studentma-maker/slj_stm32f407_pro/Document/三联机嵌入式主控板原理图_2026-08-20.pdf

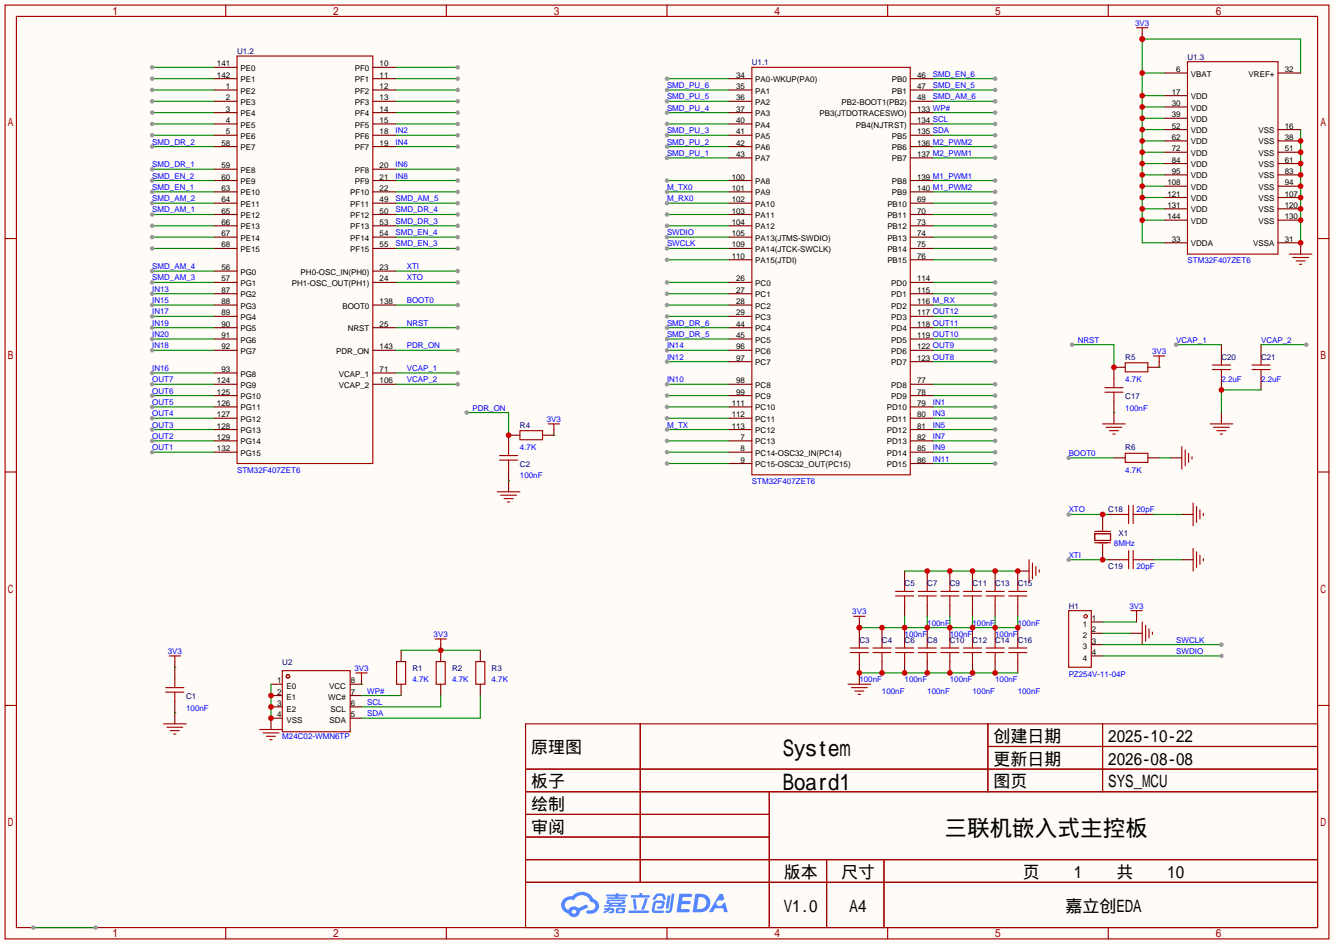
[picture p1: page 1]

原理图 | System | 创建日期 | 2025-10-22

更新日期 | 2026-08-08

板子 | Board1 | 图页 | SYS_MCU
绘制 | | 三联机嵌入式主控板
审阅

V1.0 | A4 | 嘉立创EDA

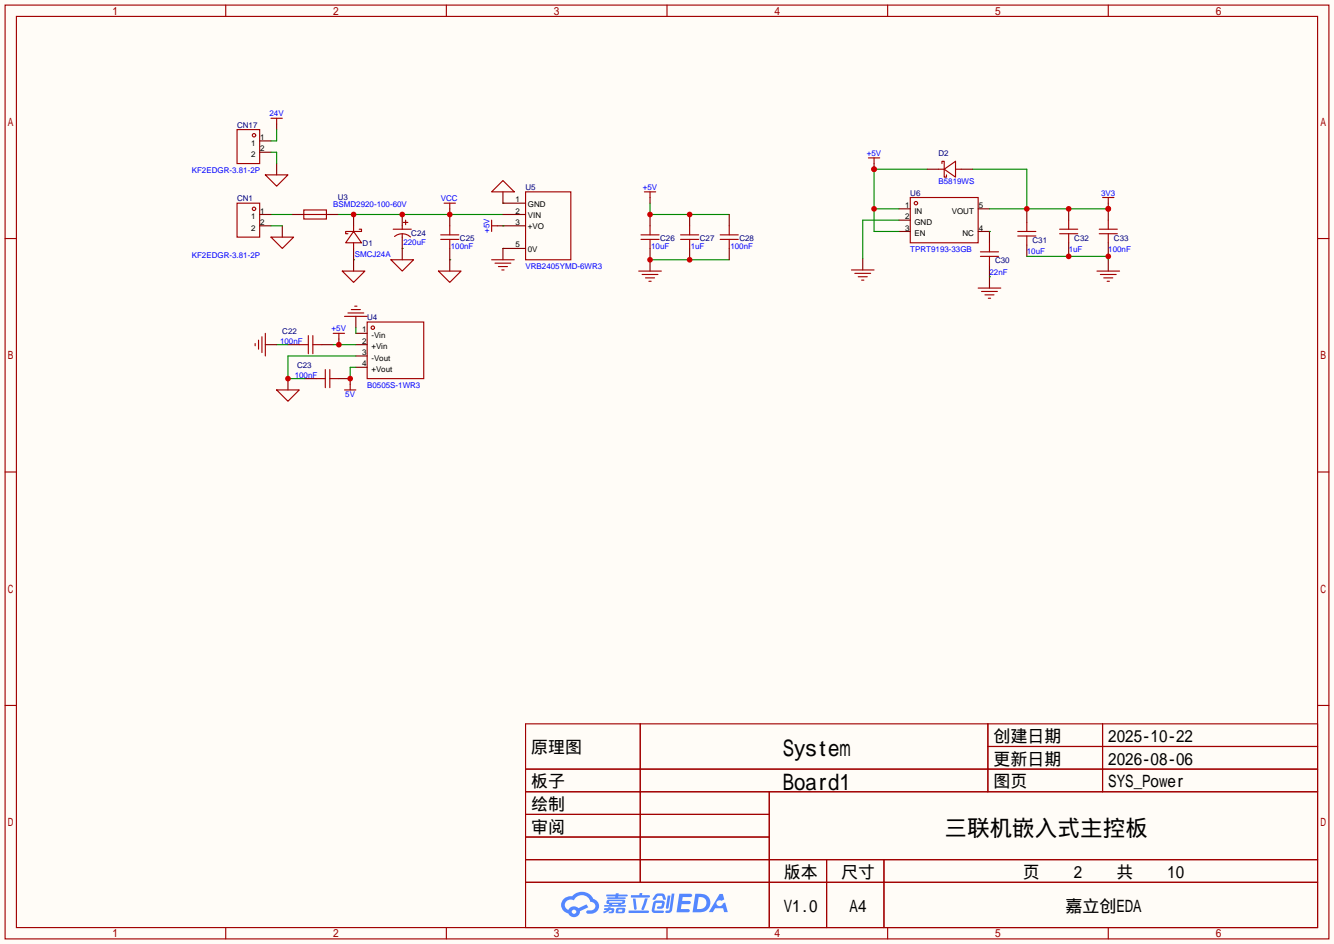
[picture p2: page 2]

原理图 | System | 创建日期 | 2025-10-22

更新日期 | 2026-08-06

板子 | Board1 | 图页 | SYS_Power
绘制 | | 三联机嵌入式主控板
审阅

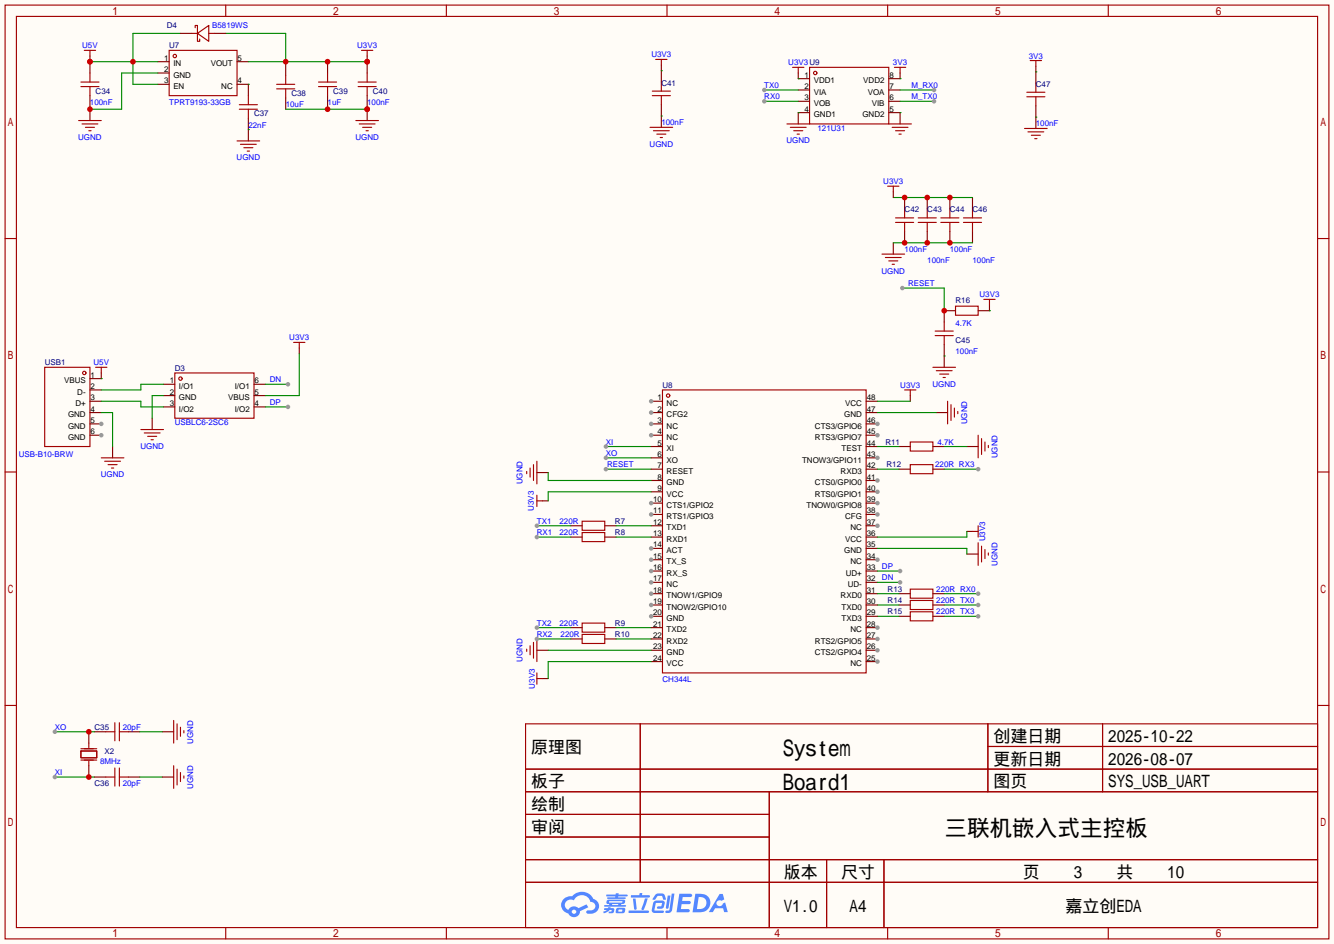
[picture p3: page 3]

原理图 | System | 创建日期 | 2025-10-22

更新日期 | 2026-08-07

板子 | Board1 | 图页 | SYS_USB_UART
绘制 | | 三联机嵌入式主控板
审阅

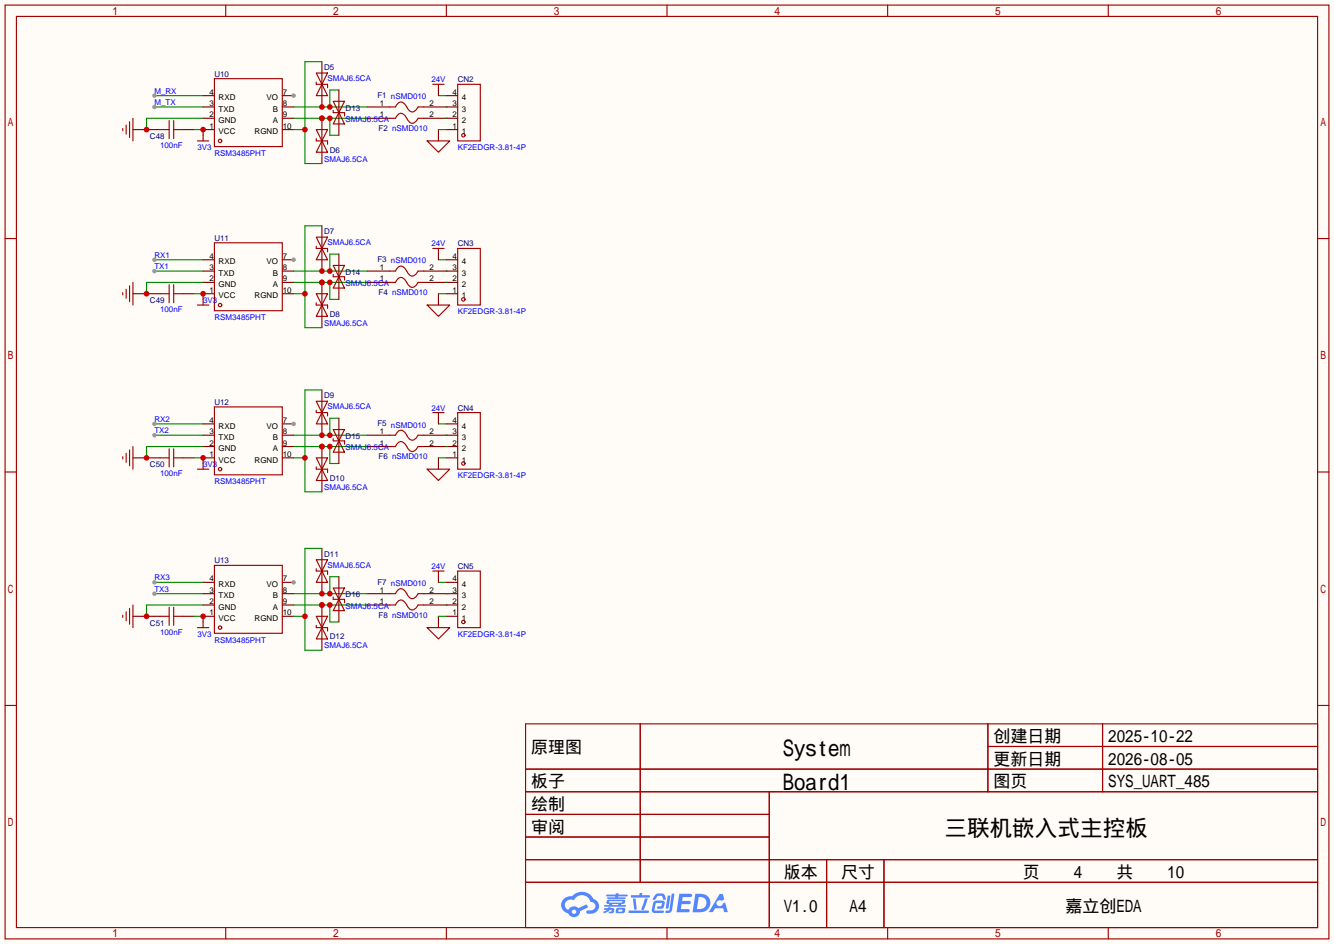
[picture p4: page 4]

原理图 | System | 创建日期 | 2025-10-22

更新日期 | 2026-08-05

板子 | Board1 | 图页 | SYS_UART_485
绘制 | | 三联机嵌入式主控板
审阅

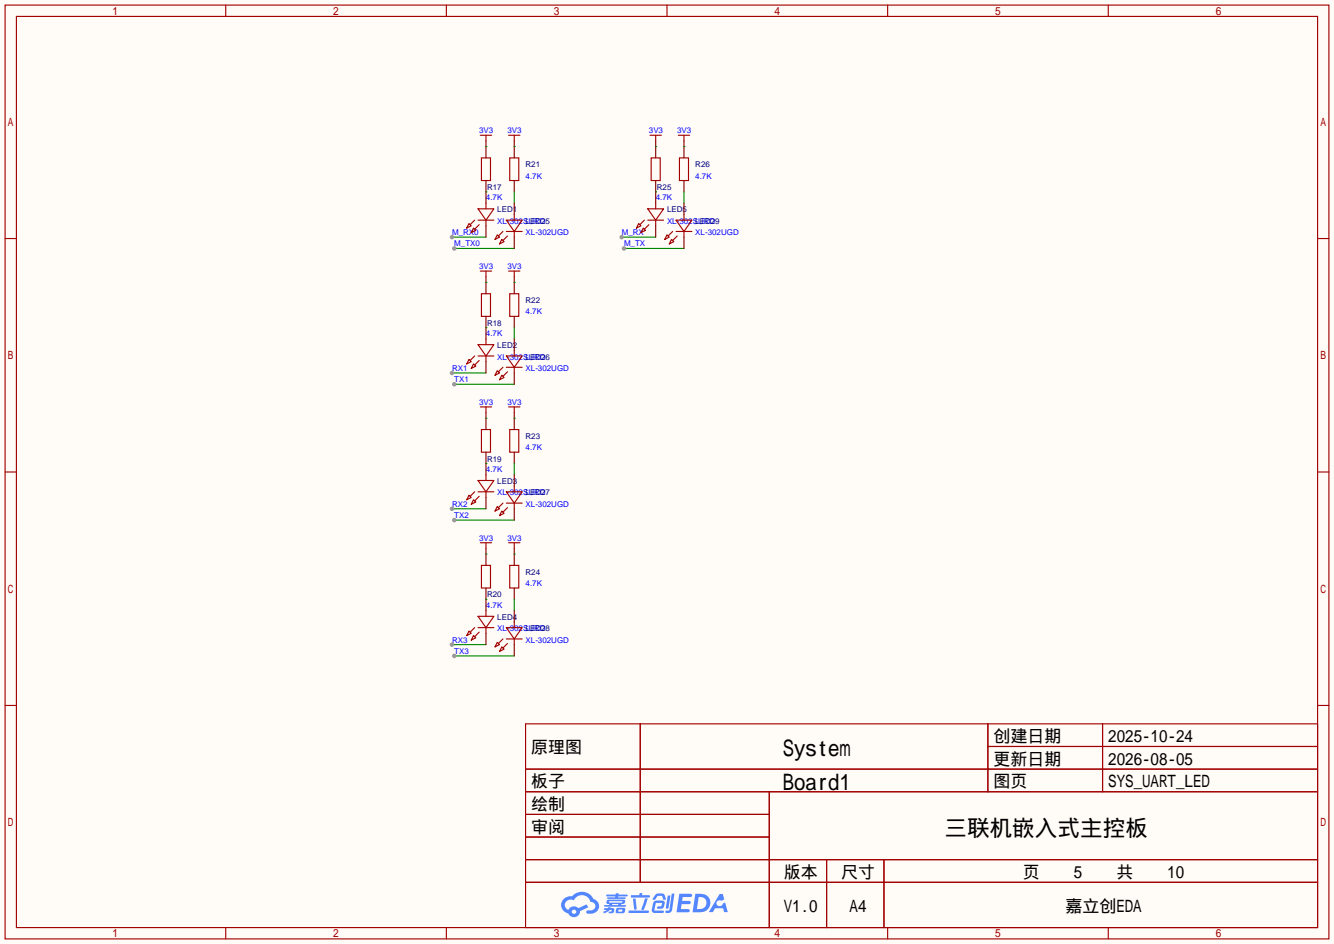
[picture p5: page 5]

原理图 | System | 创建日期 | 2025-10-24

更新日期 | 2026-08-05

板子 | Board1 | 图页 | SYS_UART_LED
绘制 | | 三联机嵌入式主控板
审阅

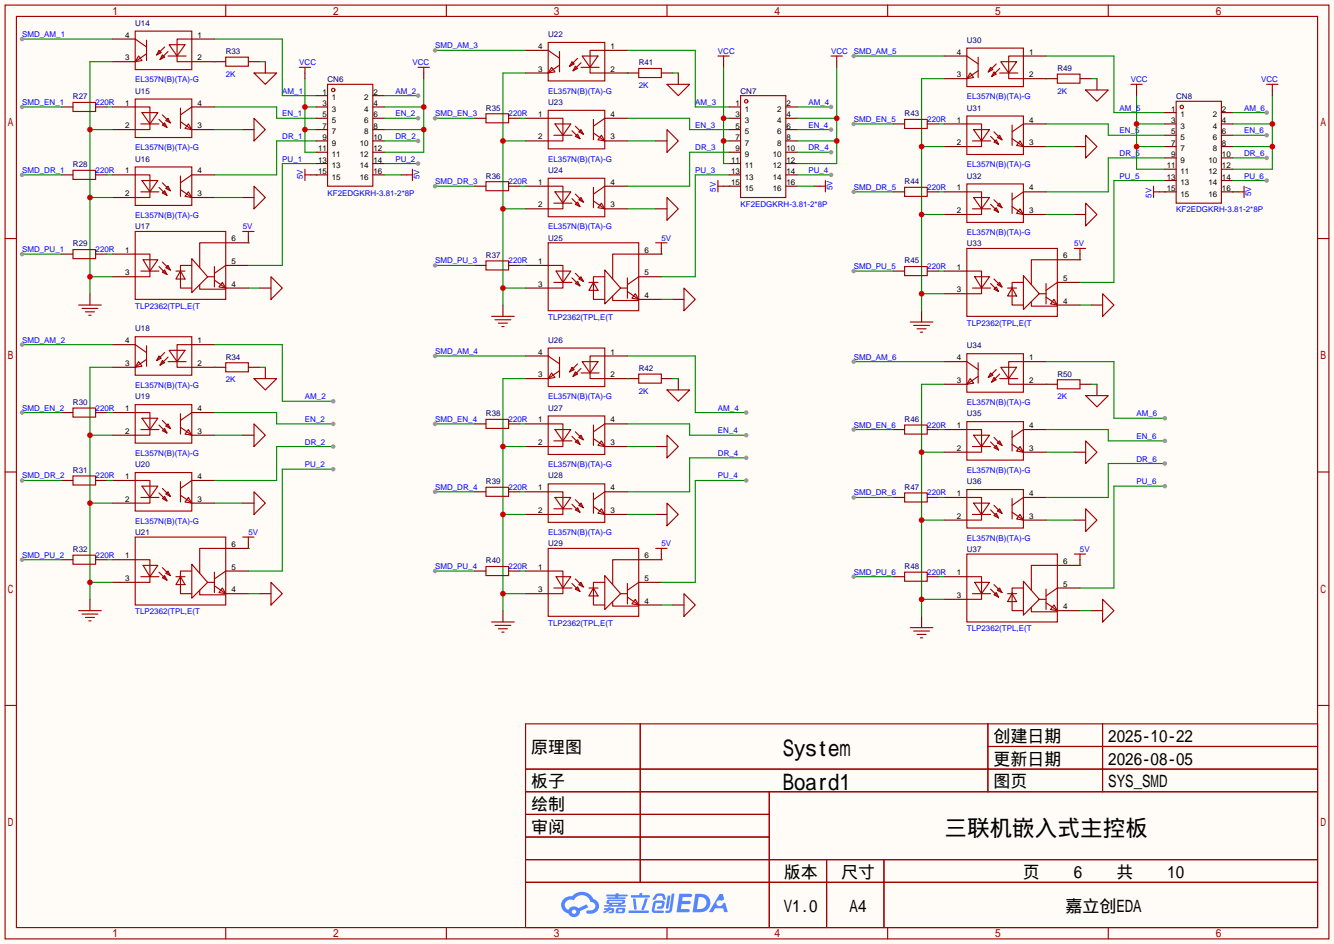
[picture p6: page 6]

原理图 | System | 创建日期 | 2025-10-22

更新日期 | 2026-08-05

板子 | Board1 | 图页 | SYS_SMD
绘制 | | 三联机嵌入式主控板
审阅

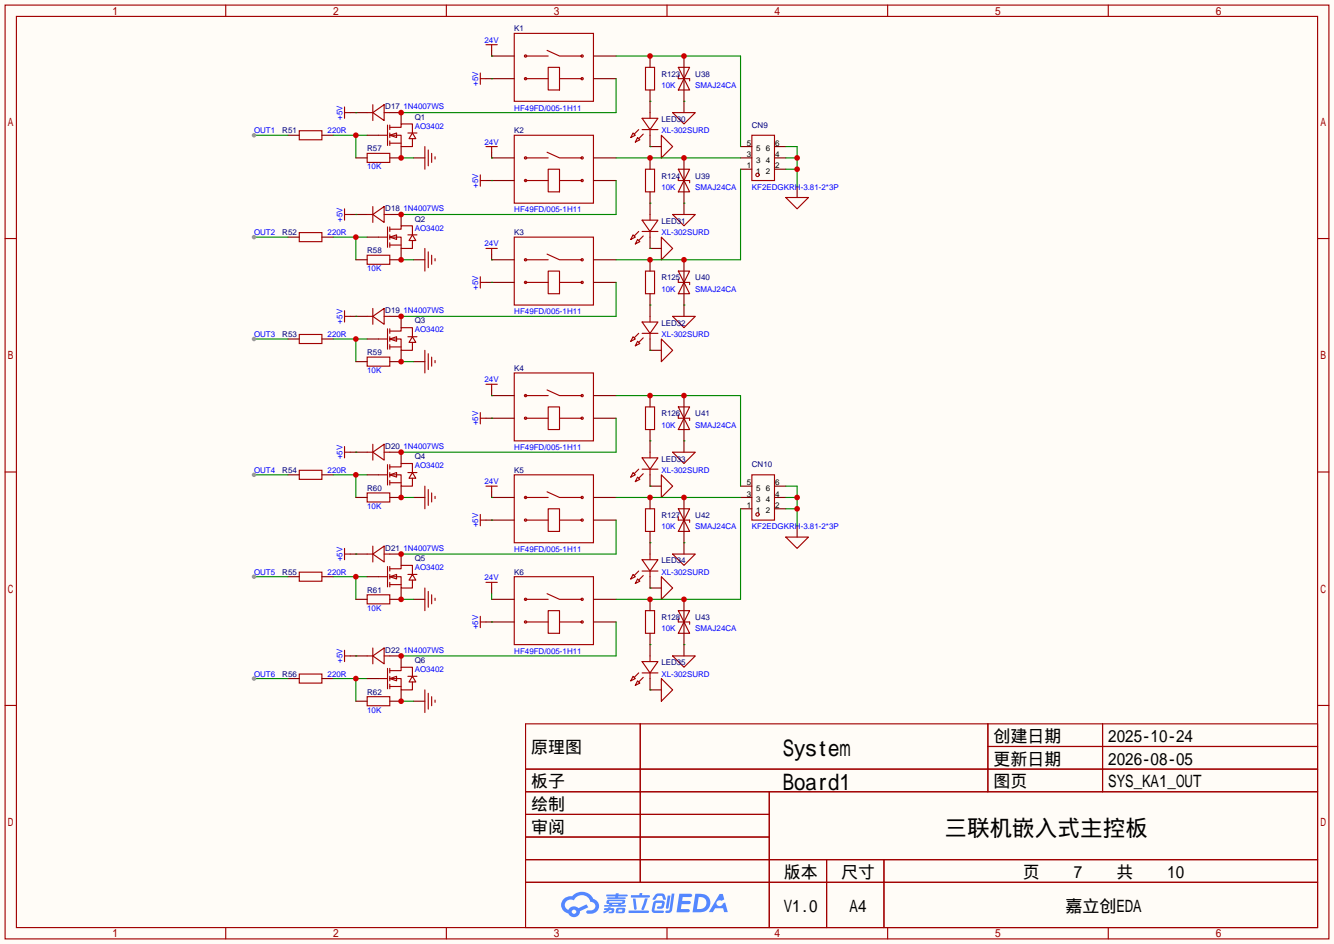
[picture p7: page 7]

原理图 | System | 创建日期 | 2025-10-24

更新日期 | 2026-08-05

板子 | Board1 | 图页 | SYS_KA1_OUT
绘制 | | 三联机嵌入式主控板
审阅

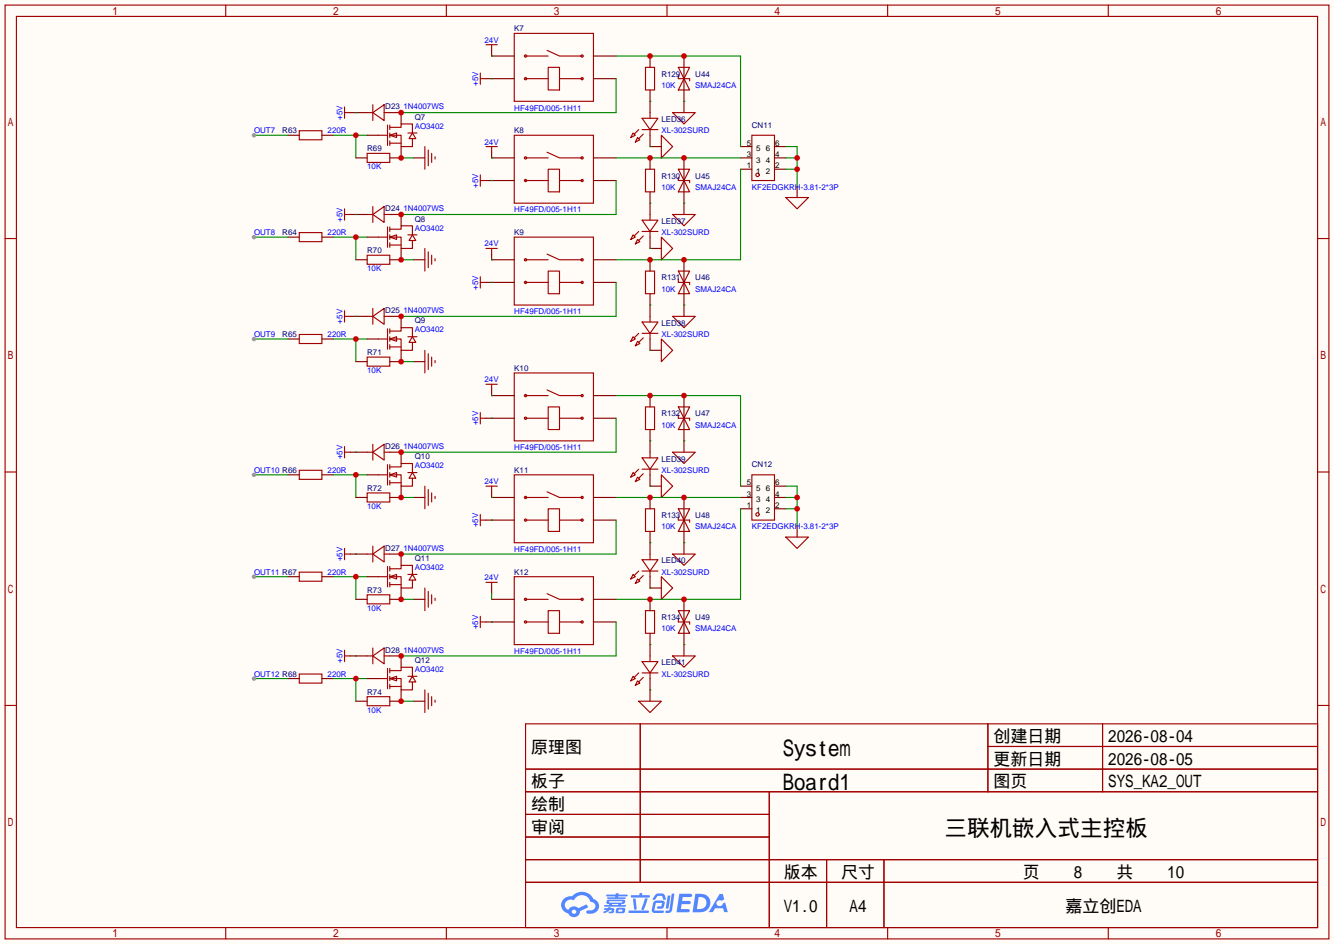
[picture p8: page 8]

原理图 | System | 创建日期 | 2026-08-04

更新日期 | 2026-08-05

板子 | Board1 | 图页 | SYS_KA2_OUT
绘制 | | 三联机嵌入式主控板
审阅

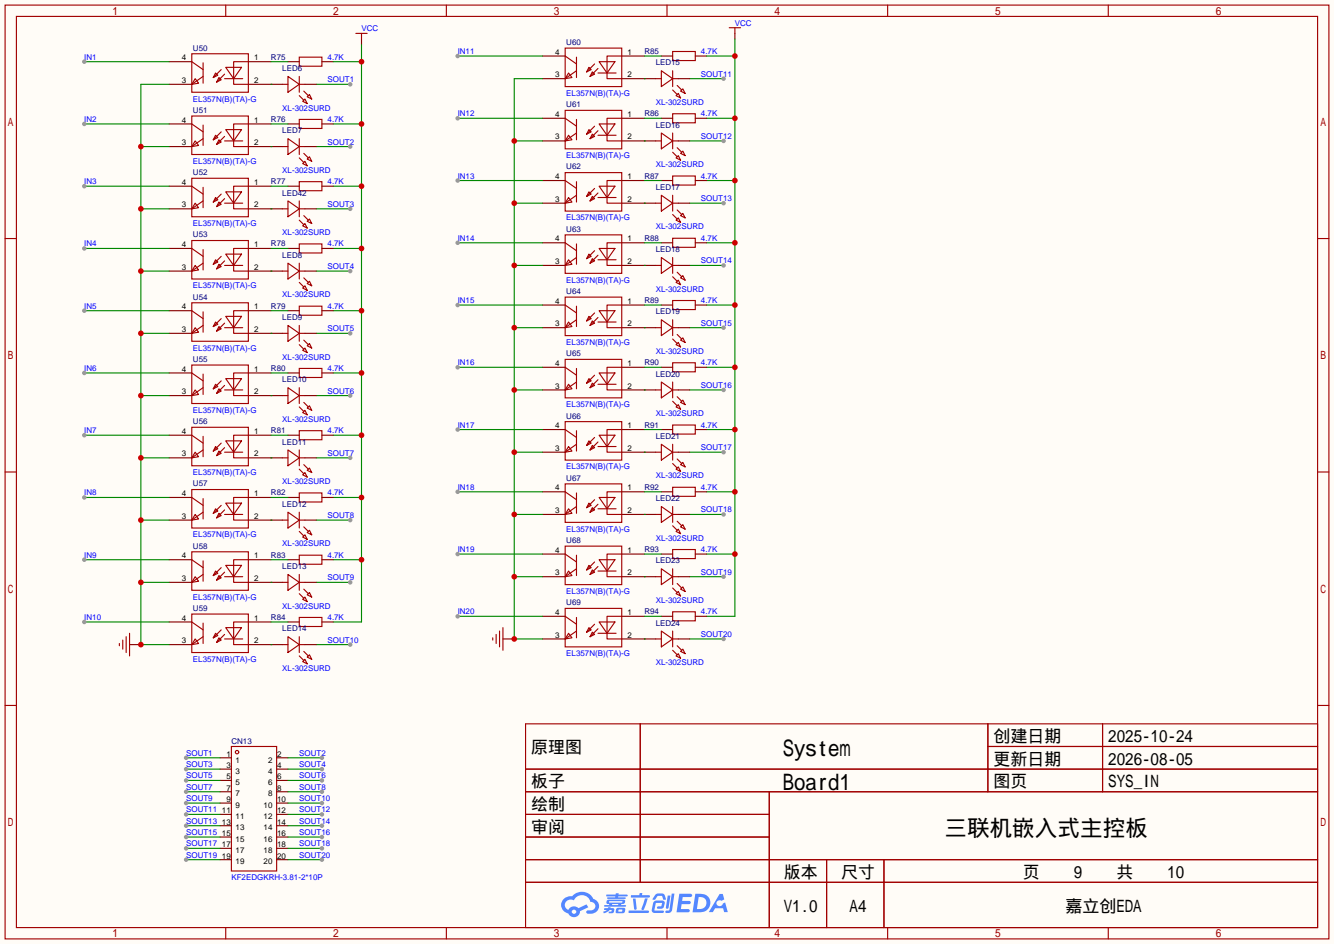
[picture p9: page 9]

原理图 | System | 创建日期 | 2025-10-24

更新日期 | 2026-08-05

板子 | Board1 | 图页 | SYS_IN
绘制 | | 三联机嵌入式主控板
审阅

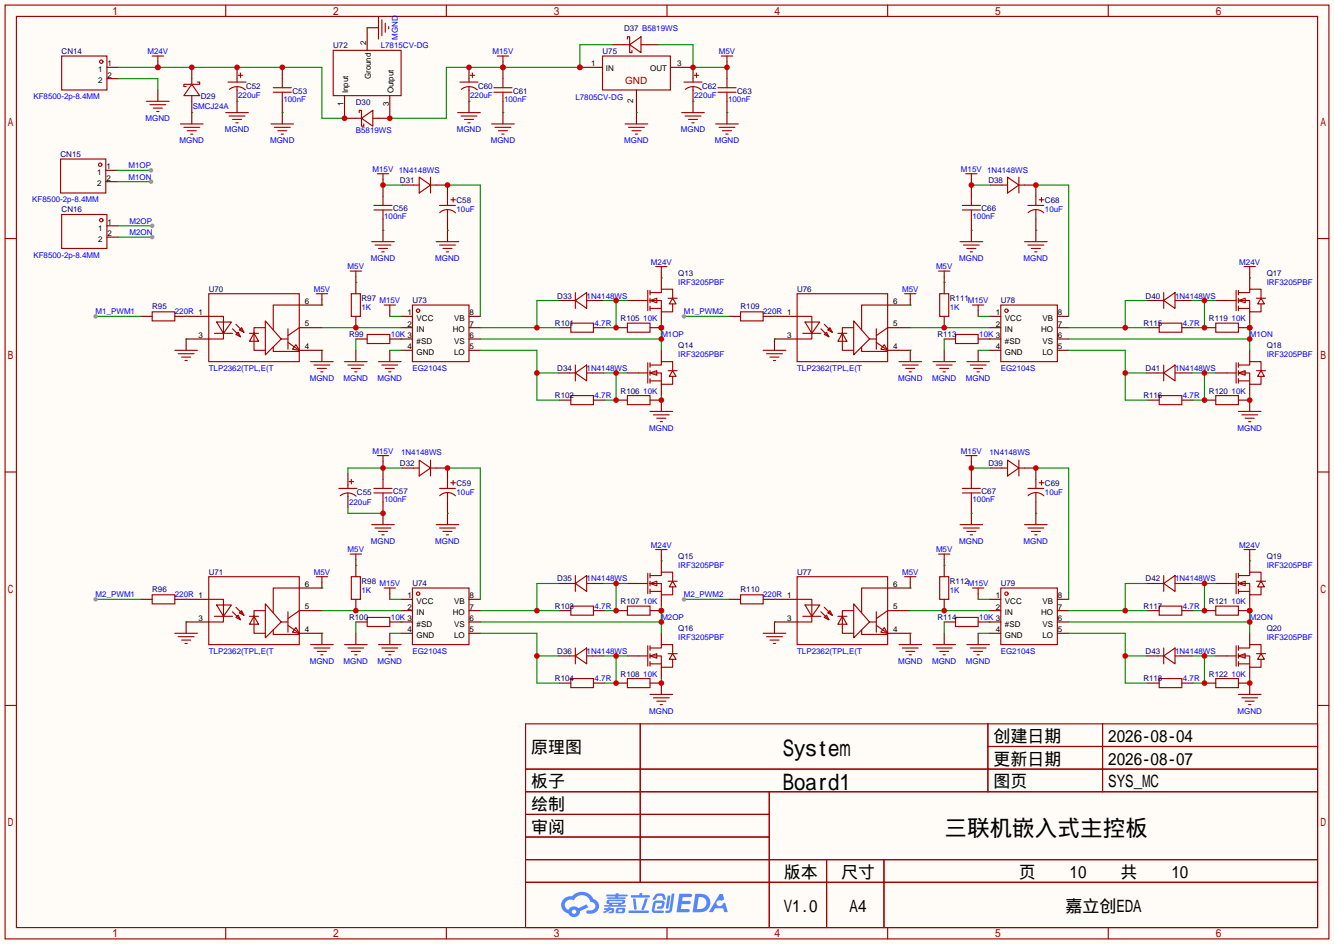
[picture p10: page 10]

原理图 | System | 创建日期 | 2026-08-04

更新日期 | 2026-08-07

板子 | Board1 | 图页 | SYS_MC
绘制 | | 三联机嵌入式主控板
审阅
