studentma-maker/slj_stm32f407_pro/Core/Src/main.c

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
/* Includes ------------------------------------------------------------------*/
#include "main.h"
#include "tim.h"
#include "usart.h"
#include "gpio.h"

/* USER CODE BEGIN Includes */
#include "mb_host.h"
#include "mb_slave.h"
#include "api_delay.h"
#include "api_timer.h"
#include "api_smd.h"
#include "api_motor_control.h"
#include "api_eeprom.h"
#include "mb_hook.h"
#include "mb_fwupd.h"
/* USER CODE END Includes */


/* USER CODE BEGIN PV */
uint32_t Cnt = 0;
extern uint32_t __Vectors[];   /* startup_stm32f407xx.s 的向量表（链接在 0x08010000，前面是 bootloader） */
/* USER CODE END PV */

void SystemClock_Config(void);
/**
  * @brief  The application entry point.
  * @retval int
  */
int main(void)
{

    /* USER CODE BEGIN 1 */
    /* 程序由 bootloader 跳转进来时 bootloader 已设好 VTOR；用 ST-Link 直接下载调试时复位后
     * 先跑 bootloader 再跳过来，同样如此。这里按链接出来的向量表地址再设一次，不依赖调用方 */
    SCB->VTOR = (uint32_t)__Vectors;
    /* USER CODE END 1 */

    /* MCU Configuration--------------------------------------------------------*/

    /* Reset of all peripherals, Initializes the Flash interface and the Systick. */
    HAL_Init();

    /* Configure the system clock */
    SystemClock_Config();

    /* Initialize all configured peripherals */
    MX_GPIO_Init();
    MX_TIM6_Init();
    MX_TIM7_Init();
    MX_UART5_Init();
    MX_USART1_UART_Init();
    MX_TIM2_Init();
    MX_TIM4_Init();
    MX_TIM5_Init();
    MX_TIM13_Init();
    MX_TIM8_Init();
    MX_TIM9_Init();
    MX_TIM10_Init();
    MX_TIM11_Init();
    MX_TIM14_Init();
    /* USER CODE BEGIN 2 */
    /* 修复S曲线抖动：CubeMX生成的定时器初始化默认关闭ARR预装载（ARPE=0），
     * 而 api_smd.c 的 SMD_ApplyFreqToHW() 每1ms在周期中途写ARR，依赖ARPE=1
     * 保证修改在下一个更新事件生效（无毛刺）。ARPE=0时，加减速阶段新ARR
     * 小于当前CNT会使16位定时器一路计到0xFFFF才回绕（最长约65ms的拉长脉冲），
     * 导致步数控制模式下电机抖动、且停不到目标位置。
     * 这里把6路步进PWM定时器按ARPE=1重新初始化（旧板smd.c即如此）。
     * 注意：必须改Init字段并重调HAL_TIM_PWM_Init，因为SMD_PWM_SetFreq()
     * 内部会再次调用HAL_TIM_PWM_Init，按Init字段把ARPE写回寄存器。
     *
     * 同时把 Init.Period 写为 19999（20ms 占位周期）：CubeMX 给 32 位定时器
     * （TIM2/TIM5）生成的 ARR=0xFFFFFFFF 若残留在影子寄存器里，ARPE=1 下
     * 运行中写入的新 ARR 要等计数器溢出（1MHz 计数 ≈71 分钟）才出现第一个
     * 更新事件——期间 PWM 引脚无脉冲（表现为开机后电机延迟执行、S曲线/步数
     * 计数空跑）。HAL_TIM_PWM_Init 内部会生成更新事件把占位周期立即锁入
     * 影子寄存器，此后任何一次启动最迟 20ms 内生效。配合 api_smd.c 的
     * SMD_Calc_PSC_ARR 最低 50Hz 钳位，运行时不再需要生成更新事件。 */
    htim2.Init.AutoReloadPreload  = TIM_AUTORELOAD_PRELOAD_ENABLE; htim2.Init.Period  = 19999; HAL_TIM_PWM_Init(&htim2);
    htim5.Init.AutoReloadPreload  = TIM_AUTORELOAD_PRELOAD_ENABLE; htim5.Init.Period  = 19999; HAL_TIM_PWM_Init(&htim5);
    htim8.Init.AutoReloadPreload  = TIM_AUTORELOAD_PRELOAD_ENABLE; htim8.Init.Period  = 19999; HAL_TIM_PWM_Init(&htim8);
    htim9.Init.AutoReloadPreload  = TIM_AUTORELOAD_PRELOAD_ENABLE; htim9.Init.Period  = 19999; HAL_TIM_PWM_Init(&htim9);
    htim13.Init.AutoReloadPreload = TIM_AUTORELOAD_PRELOAD_ENABLE; htim13.Init.Period = 19999; HAL_TIM_PWM_Init(&htim13);
    htim14.Init.AutoReloadPreload = TIM_AUTORELOAD_PRELOAD_ENABLE; htim14.Init.Period = 19999; HAL_TIM_PWM_Init(&htim14);
    Delay_Init();
    EEPROM_Init();
    SMD_Belt_Init();   /* 排发皮带一圈步数（EEPROM）+ ch4 初始电平 */
    mbh_init(&mbhMCU);
    mbs_init(&mbsUSB);
    fwu_init(FWU_MODE_APP, g_fwuInfo.ver_major, g_fwuInfo.ver_minor, g_fwuInfo.ver_patch);
    API_MOTOR_Init(&htim4, 5000);
#if M6TOSERVO_ENABLE
    /* 舵机初始化：TIM2_CH2 配 50Hz 基时，从EEPROM载入参数
     * （全0/全0xFF时写默认角度 120/120/50；行程时长不存EEPROM，开机默认5500ms），并按初始角度直接
     * 输出 PWM；DR6 拉低作舵机地线（EN6 已硬件飞线接地） */
    SMD_Servo_Init();
#endif
    for (int ch = 0; ch < SMD_CH_MAX; ch++)
    {
#if M6TOSERVO_ENABLE
        if (ch == SERVO_CH) continue;  /* 舵机通道：跳过步进S曲线启动 */
#endif
        SMD_PWM_SetFreqGradient((SMD_Channel)ch, SMD_PU_DATA[ch], SMD_ACC_DATA[ch]);
    }

    /* 开机找零：排发皮带以 BELT_ZERO_FREQ 转到 ch4 黑点（零点当场锁存）后减速停，137 皮带进度随即有效 */
    SMD_Belt_SeekZeroStart();

    SMD_GripperCounterInit();
    HAL_TIM_Base_Start_IT(&htim10);
    HAL_TIM_Base_Start_IT(&htim11);
    /* USER CODE END 2 */

    /* Infinite loop */
    /* USER CODE BEGIN WHILE */
    while (1)
    {
        
        if (bsp_timer_IsFlagSet(BSP_TIMER_FLAG_10MS))
        {
            bsp_timer_ClearFlag(BSP_TIMER_FLAG_10MS);

            uint8_t data[] = {0, 1, 0, 10};
            mbh_send(&mbhMCU, 1, 3, data, 4);

            /* 更新电机速度（非阻塞式）：由100ms周期改为10ms，配合默认2%步进，
             * 0->100%加减速时间从5秒缩短到0.5秒 */
            API_MOTOR_UpdateSpeed();
        }

        /* USER CODE END WHILE */

        /* USER CODE BEGIN 3 */
        mbh_poll(&mbhMCU);
        mbs_poll(&mbsUSB);
        SMD_Belt_SaveIfPending();   /* 皮带 EEPROM 写入：标定一圈步数/圈计数纪元/停稳位置记录（I2C 不放在中断里） */

        /* 上位机升级命令 REBOOT/ENTER_BOOT：应答发出后复位，由 bootloader 安装新固件或停在升级模式 */
        if (fwu_poll(HAL_GetTick()))
            NVIC_SystemReset();
    }

    /* USER CODE END 3 */
}

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
