studentma-maker/slj_stm32f407_pro/Core/Inc/main.h

#define IN2_Pin GPIO_PIN_6
#define IN2_GPIO_Port GPIOF
#define IN4_Pin GPIO_PIN_7
#define IN4_GPIO_Port GPIOF
#define IN6_Pin GPIO_PIN_8
#define IN6_GPIO_Port GPIOF
#define IN8_Pin GPIO_PIN_9
#define IN8_GPIO_Port GPIOF
#define SMD_DR_6_Pin GPIO_PIN_4
#define SMD_DR_6_GPIO_Port GPIOC
#define SMD_DR_5_Pin GPIO_PIN_5
#define SMD_DR_5_GPIO_Port GPIOC
#define SMD_EN_6_Pin GPIO_PIN_0
#define SMD_EN_6_GPIO_Port GPIOB
#define SMD_EN_5_Pin GPIO_PIN_1
#define SMD_EN_5_GPIO_Port GPIOB
#define SMD_AM_6_Pin GPIO_PIN_2
#define SMD_AM_6_GPIO_Port GPIOB
#define SMD_AM_5_Pin GPIO_PIN_11
#define SMD_AM_5_GPIO_Port GPIOF
#define SMD_DR_4_Pin GPIO_PIN_12
#define SMD_DR_4_GPIO_Port GPIOF
#define SMD_DR_3_Pin GPIO_PIN_13
#define SMD_DR_3_GPIO_Port GPIOF
#define SMD_EN_4_Pin GPIO_PIN_14
#define SMD_EN_4_GPIO_Port GPIOF
#define SMD_EN_3_Pin GPIO_PIN_15
#define SMD_EN_3_GPIO_Port GPIOF
#define SMD_AM_4_Pin GPIO_PIN_0
#define SMD_AM_4_GPIO_Port GPIOG
#define SMD_AM_3_Pin GPIO_PIN_1
#define SMD_AM_3_GPIO_Port GPIOG
#define SMD_DR_2_Pin GPIO_PIN_7
#define SMD_DR_2_GPIO_Port GPIOE
#define SMD_DR_1_Pin GPIO_PIN_8
#define SMD_DR_1_GPIO_Port GPIOE
#define SMD_EN_2_Pin GPIO_PIN_9
#define SMD_EN_2_GPIO_Port GPIOE
#define SMD_EN_1_Pin GPIO_PIN_10
#define SMD_EN_1_GPIO_Port GPIOE
#define SMD_AM_2_Pin GPIO_PIN_11
#define SMD_AM_2_GPIO_Port GPIOE
#define SMD_AM_1_Pin GPIO_PIN_12
#define SMD_AM_1_GPIO_Port GPIOE
#define IN1_Pin GPIO_PIN_10
#define IN1_GPIO_Port GPIOD
#define IN3_Pin GPIO_PIN_11
#define IN3_GPIO_Port GPIOD
#define IN5_Pin GPIO_PIN_12
#define IN5_GPIO_Port GPIOD
#define IN7_Pin GPIO_PIN_13
#define IN7_GPIO_Port GPIOD
#define IN9_Pin GPIO_PIN_14
#define IN9_GPIO_Port GPIOD
#define IN11_Pin GPIO_PIN_15
#define IN11_GPIO_Port GPIOD
#define IN13_Pin GPIO_PIN_2
#define IN13_GPIO_Port GPIOG
#define IN15_Pin GPIO_PIN_3
#define IN15_GPIO_Port GPIOG
#define IN17_Pin GPIO_PIN_4
#define IN17_GPIO_Port GPIOG
#define IN19_Pin GPIO_PIN_5
#define IN19_GPIO_Port GPIOG
#define IN20_Pin GPIO_PIN_6
#define IN20_GPIO_Port GPIOG
#define IN18_Pin GPIO_PIN_7
#define IN18_GPIO_Port GPIOG
#define IN16_Pin GPIO_PIN_8
#define IN16_GPIO_Port GPIOG
#define IN14_Pin GPIO_PIN_6
#define IN14_GPIO_Port GPIOC
#define IN12_Pin GPIO_PIN_7
#define IN12_GPIO_Port GPIOC
#define IN10_Pin GPIO_PIN_8
#define IN10_GPIO_Port GPIOC
#define OUT12_Pin GPIO_PIN_3
#define OUT12_GPIO_Port GPIOD
#define OUT11_Pin GPIO_PIN_4
#define OUT11_GPIO_Port GPIOD
#define OUT10_Pin GPIO_PIN_5
#define OUT10_GPIO_Port GPIOD
#define OUT9_Pin GPIO_PIN_6
#define OUT9_GPIO_Port GPIOD
#define OUT8_Pin GPIO_PIN_7
#define OUT8_GPIO_Port GPIOD
#define OUT7_Pin GPIO_PIN_9
#define OUT7_GPIO_Port GPIOG
#define OUT6_Pin GPIO_PIN_10
#define OUT6_GPIO_Port GPIOG
#define OUT5_Pin GPIO_PIN_11
#define OUT5_GPIO_Port GPIOG
#define OUT4_Pin GPIO_PIN_12
#define OUT4_GPIO_Port GPIOG
#define OUT3_Pin GPIO_PIN_13
#define OUT3_GPIO_Port GPIOG
#define OUT2_Pin GPIO_PIN_14
#define OUT2_GPIO_Port GPIOG
#define OUT1_Pin GPIO_PIN_15
#define OUT1_GPIO_Port GPIOG
#define I2C_WR_Pin GPIO_PIN_3
#define I2C_WR_GPIO_Port GPIOB
#define I2C_SCL_Pin GPIO_PIN_4
#define I2C_SCL_GPIO_Port GPIOB
#define I2C_SDA_Pin GPIO_PIN_5
#define I2C_SDA_GPIO_Port GPIOB
#define M2_PWM2_Pin GPIO_PIN_6
#define M2_PWM2_GPIO_Port GPIOB
#define M2_PWM1_Pin GPIO_PIN_7
#define M2_PWM1_GPIO_Port GPIOB
#define M1_PWM1_Pin GPIO_PIN_8
#define M1_PWM1_GPIO_Port GPIOB
#define M1_PWM2_Pin GPIO_PIN_9
#define M1_PWM2_GPIO_Port GPIOB
#define RELAY_1             0
#define RELAY_FeedHair      1
#define RELAY_PressHair     2
#define RELAY_WarnYELLOW    7
#define RELAY_CartUp        10
#define RELAY_CartDown      11
#define WarnLED_on              1
#define WarnLED_off             0
#define RELAY_FeedHair_up       1   // 送发气缸：0=下降/1=上升
#define RELAY_PressHair_up      1   // 压发气缸：0=下降/1=上升
