studentma-maker/slj_stm32f407_pro/(commit log)

2026-09-09 Add Keil project source: HAL drivers, middleware, Modbus RTU, MDK-ARM project
    Import the STM32F407 project (Core/Drivers/Middleware/Modbus_RTU sources,
    CubeMX .ioc, and the MDK-ARM Keil project) so it can be cloned and built
    directly in Keil on another machine. Adds .gitignore to keep compiler-
    generated intermediates (objects, listings, maps, images, per-user GUI
    state) out of version control.
    Claude-Session: https://claude.ai/code/session_01NdMnsDpTKBCWiPs6LA3tqd
2026-09-09 移植旧板S曲线步数控制与Modbus寄存器映射到新板
    将 slj_stm32f407 旧板（8路）的电机S曲线加减速、步数控制、限位急停、上电回原点
    状态机移植到本板6路步进电机骨架，并扩展 mb_hook 寄存器表新增 JRK/STEP/CS 字段，
    上位机仅需更换寄存器地址映射即可复用协议。同时修复 Project.ioc/gpio.c 中
    SMD_DR_2(PE7) 被误配置为外部中断输入、方向控制不生效的问题。
    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
    [Project.ioc, main.h, mb_hook.c, mb_hook.h]
2026-09-09 将IN/OUT/SYS_TO_ORIGIN寄存器地址对齐旧板slj_stm32f407
    IN1~IN20移至112~131，SYS_TO_ORIGIN移至133，与旧板地址完全一致；
    OUT1~OUT12起始地址80本就与旧板相同，未变动。M1/M2直流电机寄存器为
    新板独有功能，旧板无对应地址，暂沿用原有取值(100~103)。mb_hook.c
    全部通过宏访问寄存器地址，无需改动。
    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
2026-09-09 直流电机的限位，部分寄存器地址的同步
2026-09-09 兼容修改基本完成
2026-09-09 直流电机控制和原版继电器控制兼容！
2026-09-10 波特率和从机地址默认值修改
2026-09-11 输入端口序号修正
2026-09-11 撤销输入端口序号对调，改由硬件丝印重新标注解决
    Claude-Session: https://claude.ai/code/session_017XrXDqx65zG6Vbz6dWW5yq
2026-09-11 新增料车继电器电机限位保护（OUT11/12，M1/M2驱动未调通前的备用方案）
    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
2026-09-15 注释掉继电器控制电机，恢复M1/2的限位控制
2026-09-16 M1/2限位急停由立即停止改为快速缓停
    限位/急停触发时不再瞬间切断PWM输出，而是将目标速度置0走斜坡降速，
    避免对机构造成硬性冲击；新增独立步进系数g_motor_estop_step_percent
    (默认8，满量程约130ms)，明显快于正常缓起步进g_motor_step_percent
    (默认2，满量程约500ms)，兼顾缓冲与响应速度。
2026-09-21 皮带电机的步数记录
2026-09-21 步进PWM定时器启用ARR预装载，修复S曲线加减速抖动与步数停位偏差
    CubeMX生成的定时器初始化默认ARPE=0，SMD_ApplyFreqToHW每1ms周期中途
    写ARR立即生效，新ARR小于当前CNT时16位定时器计到0xFFFF才回绕，产生
    最长约65ms的拉长脉冲，导致夹爪步数控制模式抖动、终点位置偏差。
    按旧板smd.c方式对TIM2/5/8/9/13/14重新以ARPE=1初始化。
2026-09-22 电机控制改造为舵机控制
2026-09-23 修复32位定时器导致的电机无S曲线加减速与开机延迟执行
    TIM2/TIM5 是 32 位定时器，CubeMX 初始 ARR=0xFFFFFFFF：ARPE=1 下
    运行中写入的新 ARR 要等更新事件（计数器溢出）才生效，首次输出
    最长延迟 2^32/1MHz≈71 分钟（S曲线/步数计数照跑但无脉冲输出，
    表现为开机后电机延迟执行、步数到了位置没到）。1Hz"减速停止"哨兵
    值又会把 999999（1 秒周期）锁进影子寄存器，把 S 曲线缓起整段
    "空跑"掉，启动时频率直接跳到高频（16 位定时器 ARR 截断成 16 位，
    最长仅 65.5ms，所以此前夹爪在 TIM9 上无此现象）。
    修复采用初始化期一次性消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
2026-10-13 舵机信号改经反相光耦输出，并加临时自动往复测试
    新舵机改为 PA1 经反相光耦 TLP2362 驱动信号线：新增 SERVO_PWM_INVERT
    开关（现为1），Servo_AngleToCCR 返回 周期-脉宽，使引脚输出反相波形，
    经光耦再反一次后舵机端仍是 0.5~2.5ms 正脉冲。改回直连时置0。
    新增临时测试开关 SERVO_AUTO_SWEEP_TEST（现为1）：上电后无需上位机
    指令，舵机在 0°~180° 间匀速往复（单程 SERVO_AUTO_SWEEP_HALF_MS=2s），
    急停按下时暂停；期间 Modbus 的舵机启停指令无效。测试完须改回0。
2026-10-14 舵机行程时长改为不存EEPROM，新增手动跳角度，关闭临时往复测试
    - 行程时长（寄存器53）仅内存生效，开机默认5500ms；由上位机每次启动时
    与启动指令一帧下发（连写53~54）。EEPROM地址16仍为4×uint16，第4字保留
    - 寄存器55写入=手动直接跳到该角度（不保存），供上位机标定角度
    - SERVO_AUTO_SWEEP_TEST 改回0，关闭上电自动往复测试
    - README 补充6号通道舵机化的寄存器、接线与光耦上拉说明
2026-10-14 断线检测输入枚举按缝纫机重命名，与上位机 reg_map.h 同步
    Incom_LineBroken1~4 改为 Incom_LineBroken_1_1 / _1_2（1号缝纫机两根线）、
    Incom_LineBroken_2 / _3（2号、3号缝纫机），仅别名变化，索引不变
2026-10-14 舵机到达角度b后停留1000ms再回初始角度
    - 流程新增 SERVO_HOLD_B 阶段：a→b 插值完成后在b停留
    SERVO_HOLD_AT_B_MS（1000ms），再跳回初始角度
    - 停留期间仍算运行中（56读回1，重复启动被忽略），写56=0/急停/
    手动跳角度可提前中止
    - 注释与 README 同步
2026-10-14 单电机SP=0与全部电机急停时同步把寄存器镜像PU置1，避免下一帧写入把电机按旧频率重新拉起
    停止时原先只把内部目标 SMD_PU_DATA 置 1，regHoldingBuf 里的 PU 仍是停止前的频率；
    下一帧任意寄存器写入时"PU写入"判断发现镜像 != 内部目标，会按旧频率重新启动电机。
    停止帧与下一写帧之间没有轮询读刷新镜像时必现（实测排发硬停后又以旧频率缓慢转动）。
2026-10-15 IN1改作ch4排发皮带零点光电；新增皮带一圈进度寄存器137（定点数/65536）与手动标定寄存器198：两次ch4上升沿得一圈步数，直接停皮带并存EEPROM
2026-10-16 皮带一圈步数标定改为连续采6圈：第1到第7次ch4上升沿步数÷6取平均，第7次上升沿直接停皮带；放弃条件改为走满8圈
2026-10-16 开机找零：初始化时排发皮带以4000Hz转到ch4黑点（零点当场锁存）后S曲线减速停，1.5圈未见黑点放弃；上位机写DR/STEP/PU/SP或皮带被停掉时中止找零/标定判定，自启停时同步DR/PU寄存器镜像
2026-10-16 开机找零皮带频率由4000Hz提高到8000Hz（同生产高速），找零最长时间约减半
2026-10-17 皮带零点/标定加固：一圈步数默认值改为227138（10-16两次6圈标定平均），限定合理范围±20%（EEPROM越界用默认值、标定越界不写EEPROM）；距上一零点不足0.9圈的ch4上升沿忽略；标定先启动PWM再置状态，消除与1ms中断的竞态
2026-10-19 皮带停稳位置记录+开机找零核对+圈计数：排发电机停稳500ms把距零点步数与圈计数写EEPROM（64~127共8槽轮流写，开动即作废，不依赖关机命令）；开机有记录时第一个零点只接受预期位置±1/20圈窗口内的ch4上升沿，窗口前的皮带污点忽略、找零继续，越窗判核对失败回常规；新增圈计数（每零点加经过整圈数，模60000）与纪元（无记录/核对失败/反转时+1，EEPROM 28~29），只读寄存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
2026-10-20 排发皮带支持反转：方向不是BELT_CALIB_DR时脉冲总数累减（135/136正转加、反转减）；零点改为黑点前沿（正转ch4上升沿/反转ch4下降沿，同一物理位置），零点门限按有符号距离判0.9圈，圈计数反转时减整圈数（模60000取正）；反转越过零点进度退回上一圈、圈计数-1，正反向超出一圈视为漏检无效；反转不再作废零点/断开计数链，只有开机零点核对中反转才放弃核对并纪元+1；新增SMD_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
2026-10-20 上位机经Modbus在线升级下位机：Flash分区改为bootloader(0x08000000,32KB)/升级记录(扇区2)/应用(0x08010000,192KB)/下载区(0x08040000,256KB)，应用工程IROM1改为0x08010000/0x30000，main开头按__Vectors设VTOR，编译后fromelf生成MDK-ARM\Project\slj_mcu.bin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
2026-10-29 feat: add hardware pulse counting and adaptive braking for gripper
